kinthelt/be6502/kicad/be6502.pdf

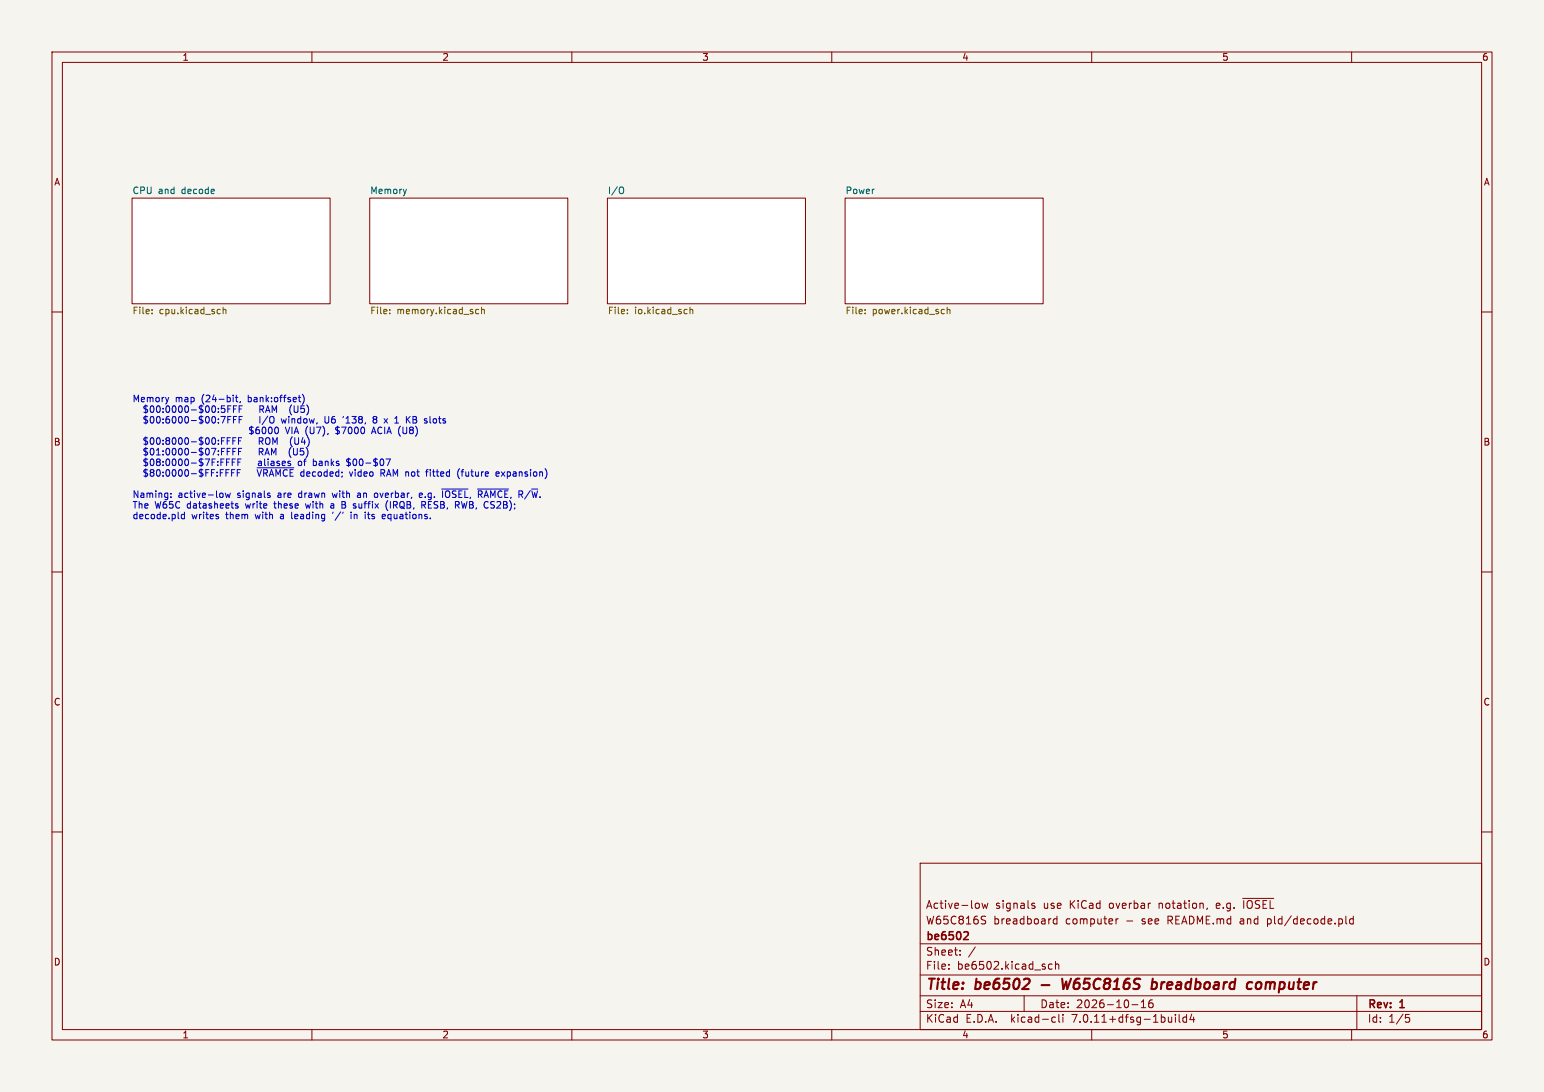
[picture p1: page 1]

CPU and decode File: cpu.kicad_sch

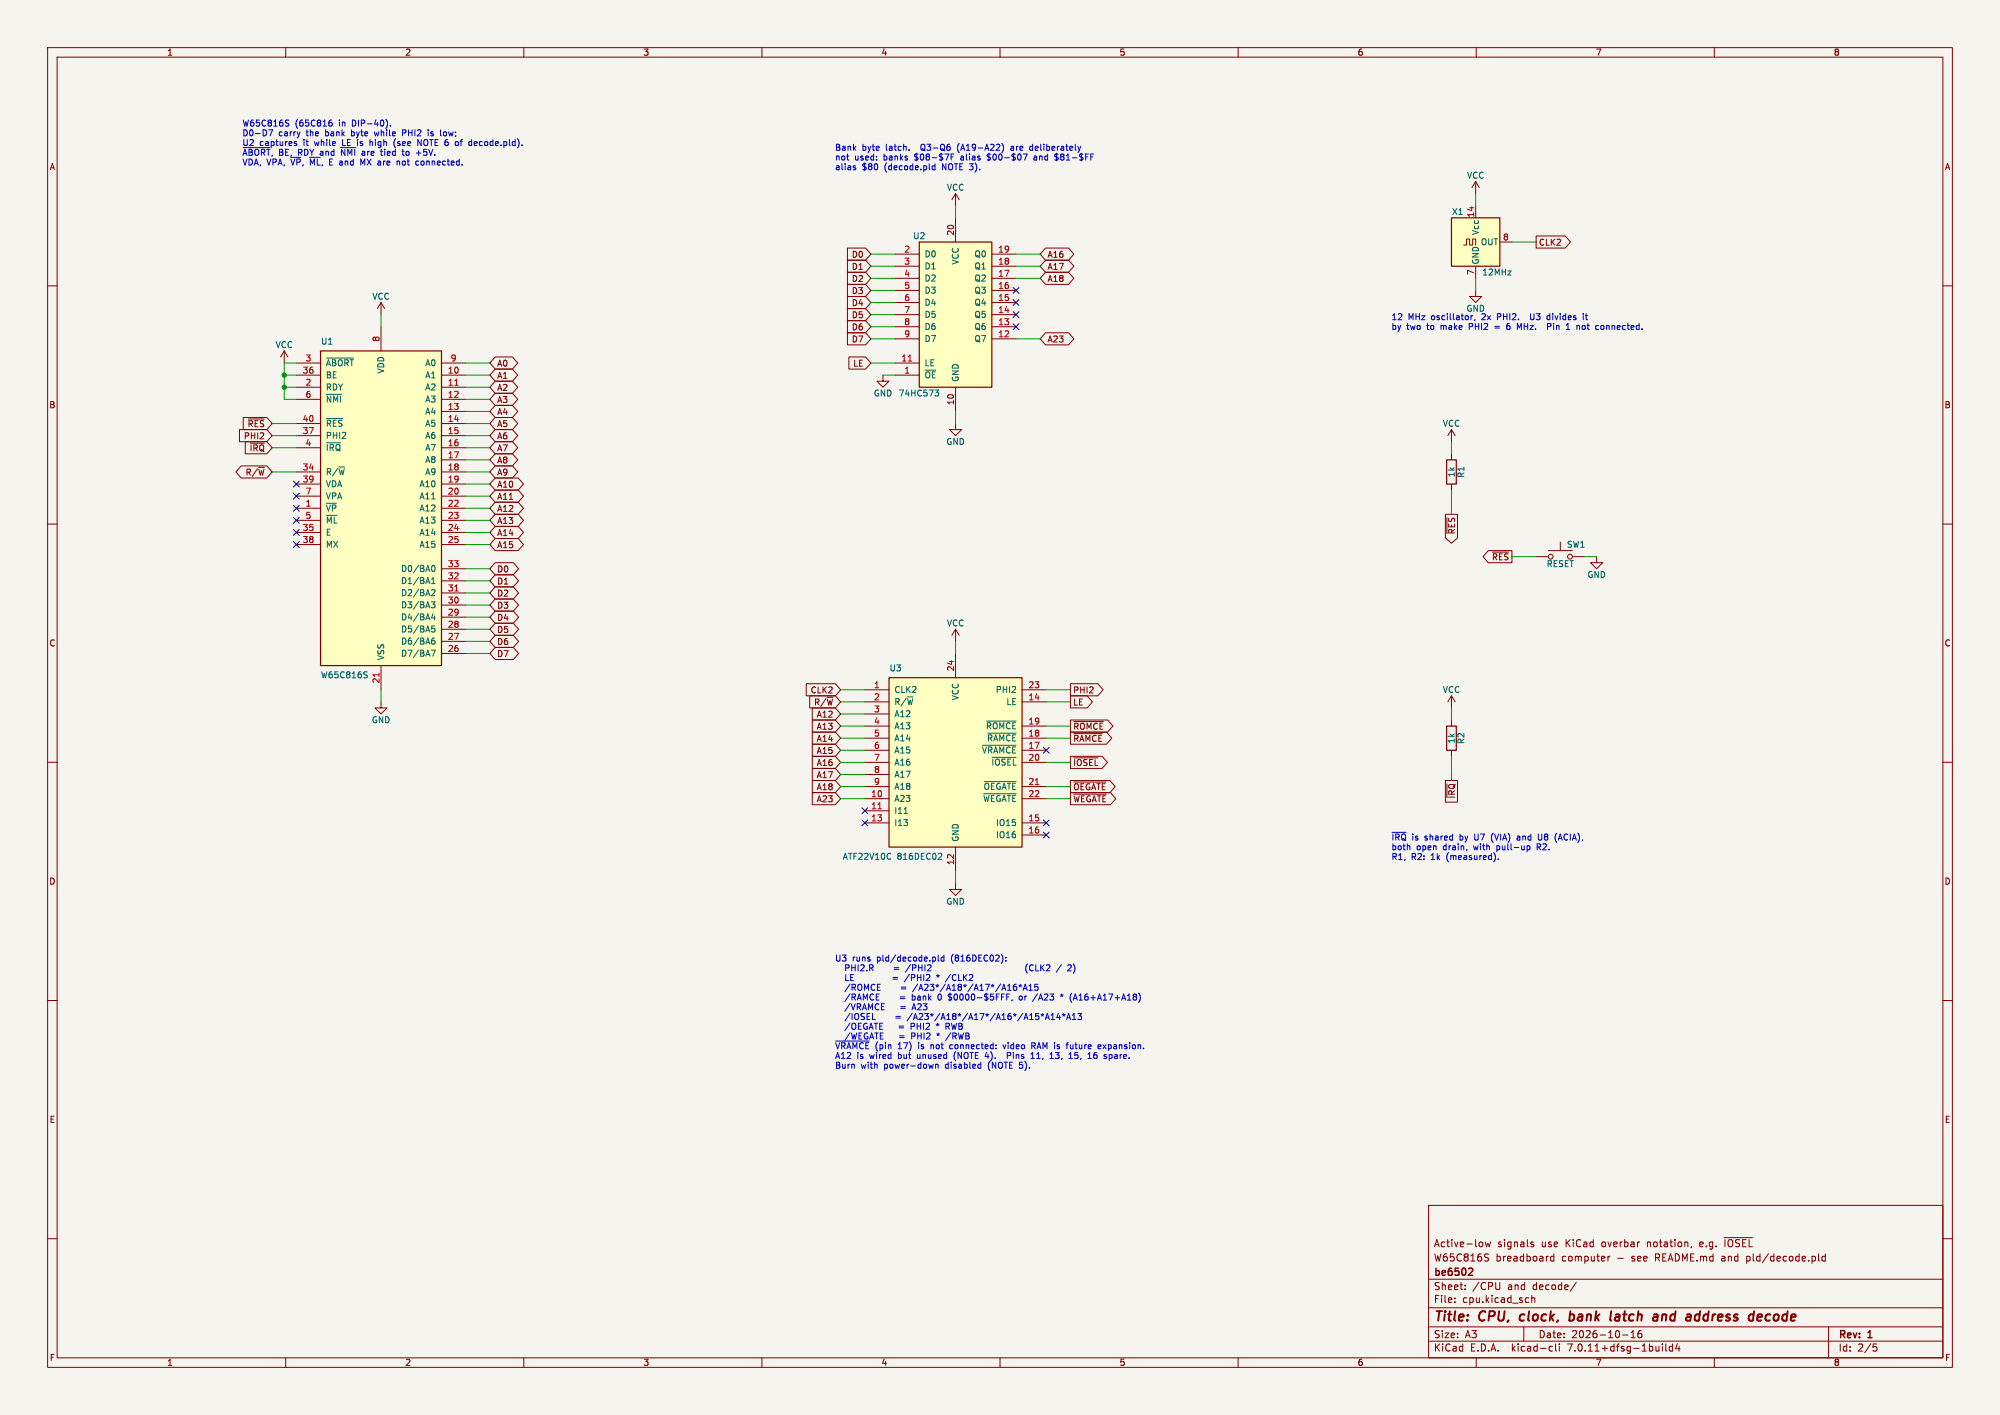
[picture p2: page 2]

~{ABORT},BE, RDY and ~{NMI}are tied to +5V. VDA, VPA, ~{VP},~{ML},E and MX are not connected.

Id: 2/5 Title: CPU, clock, bank latch and address decode

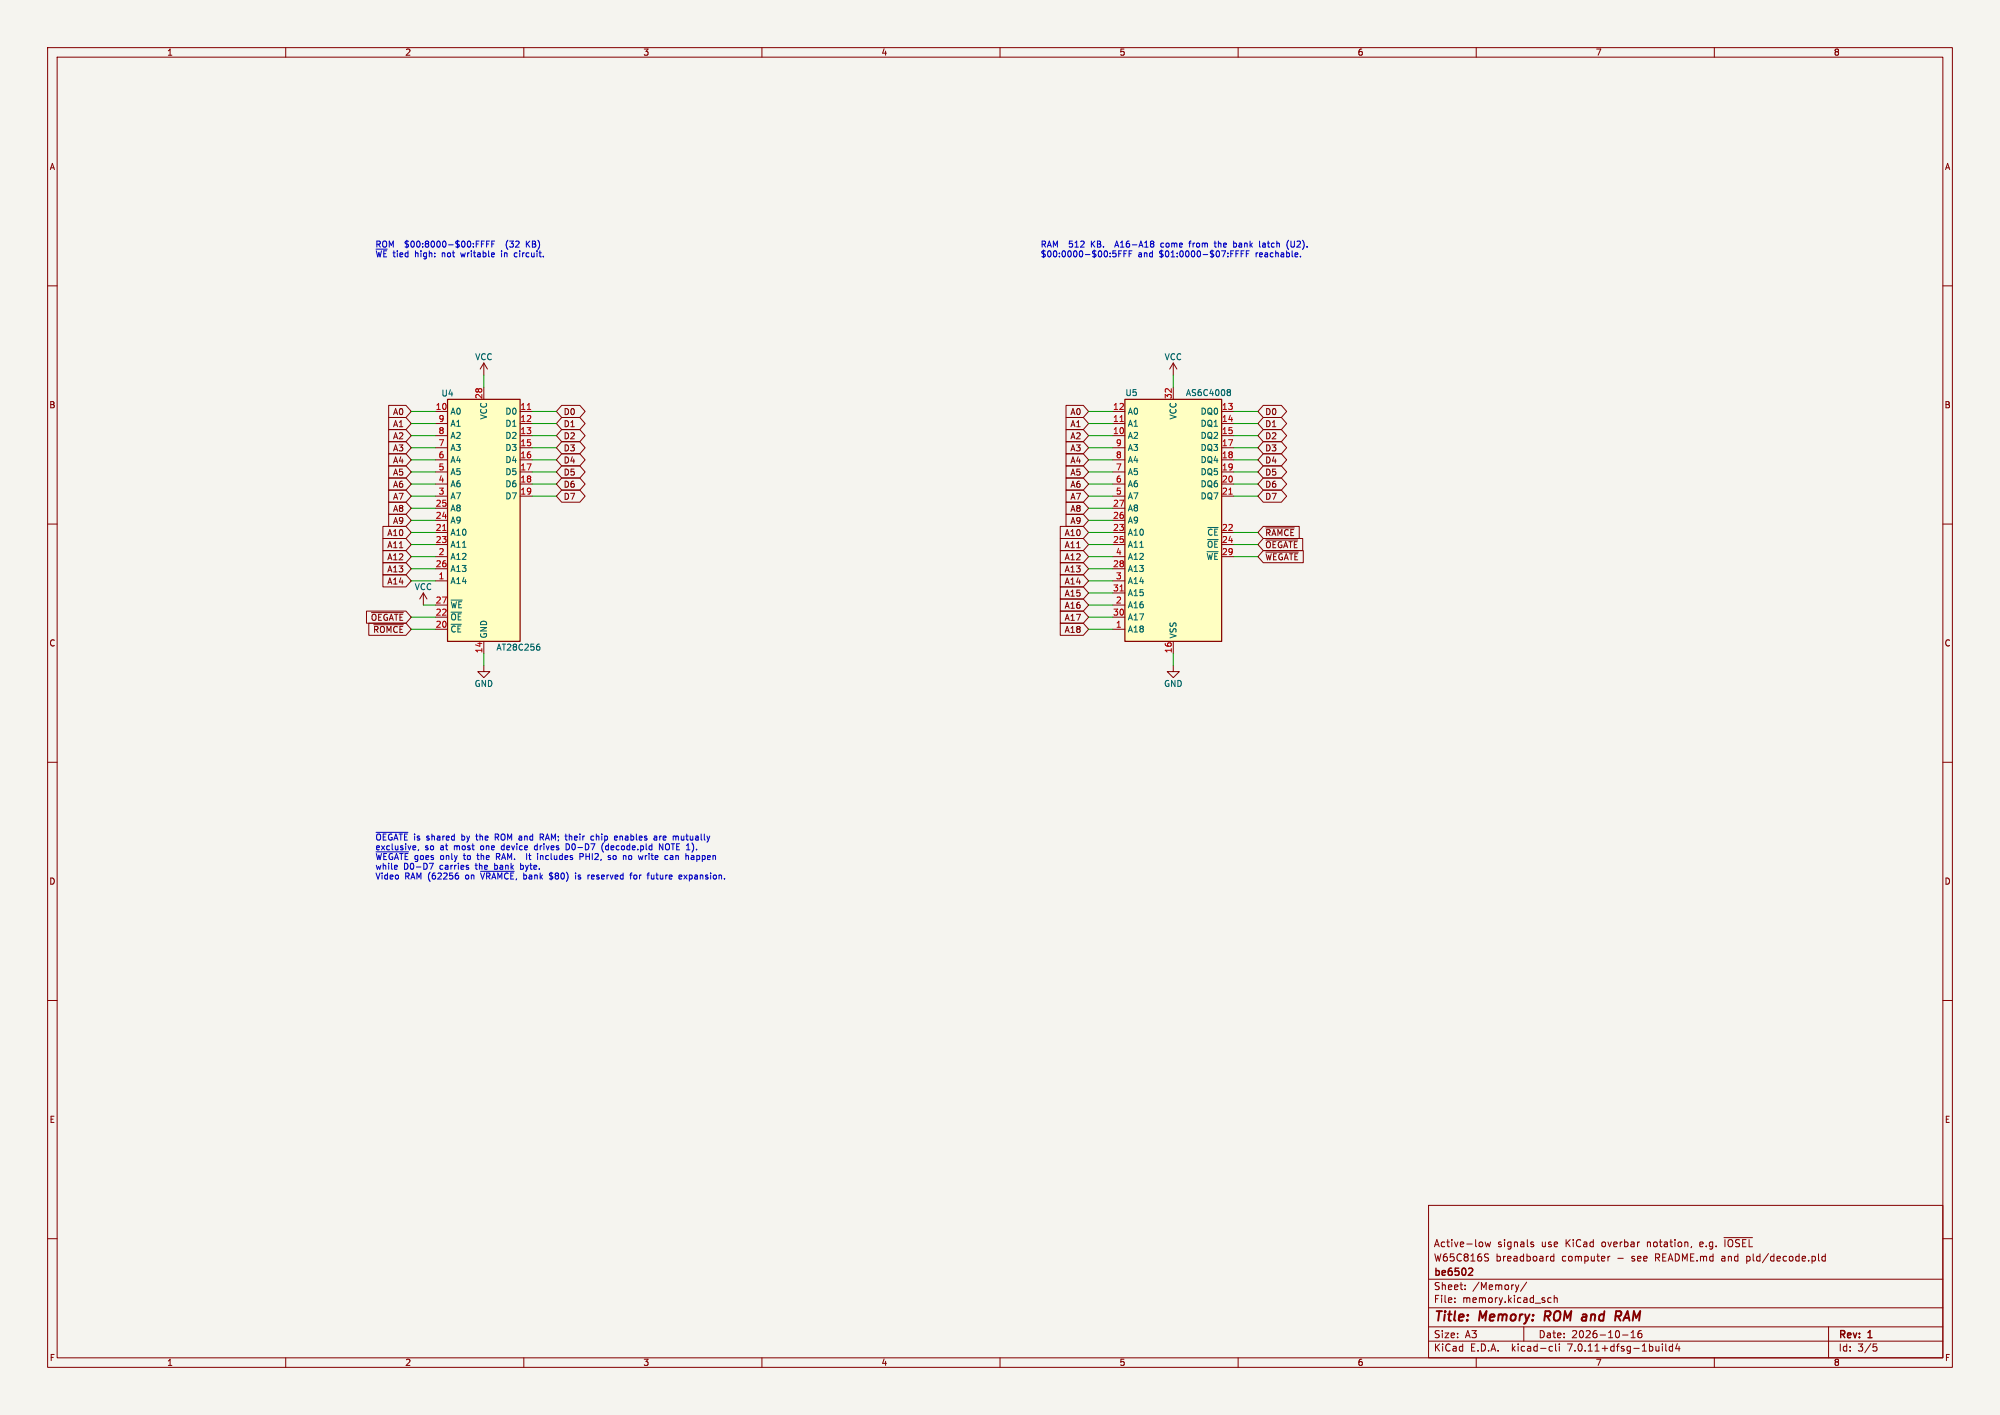
[picture p3: page 3]

Id: 3/5 Title: Memory: ROM and RAM

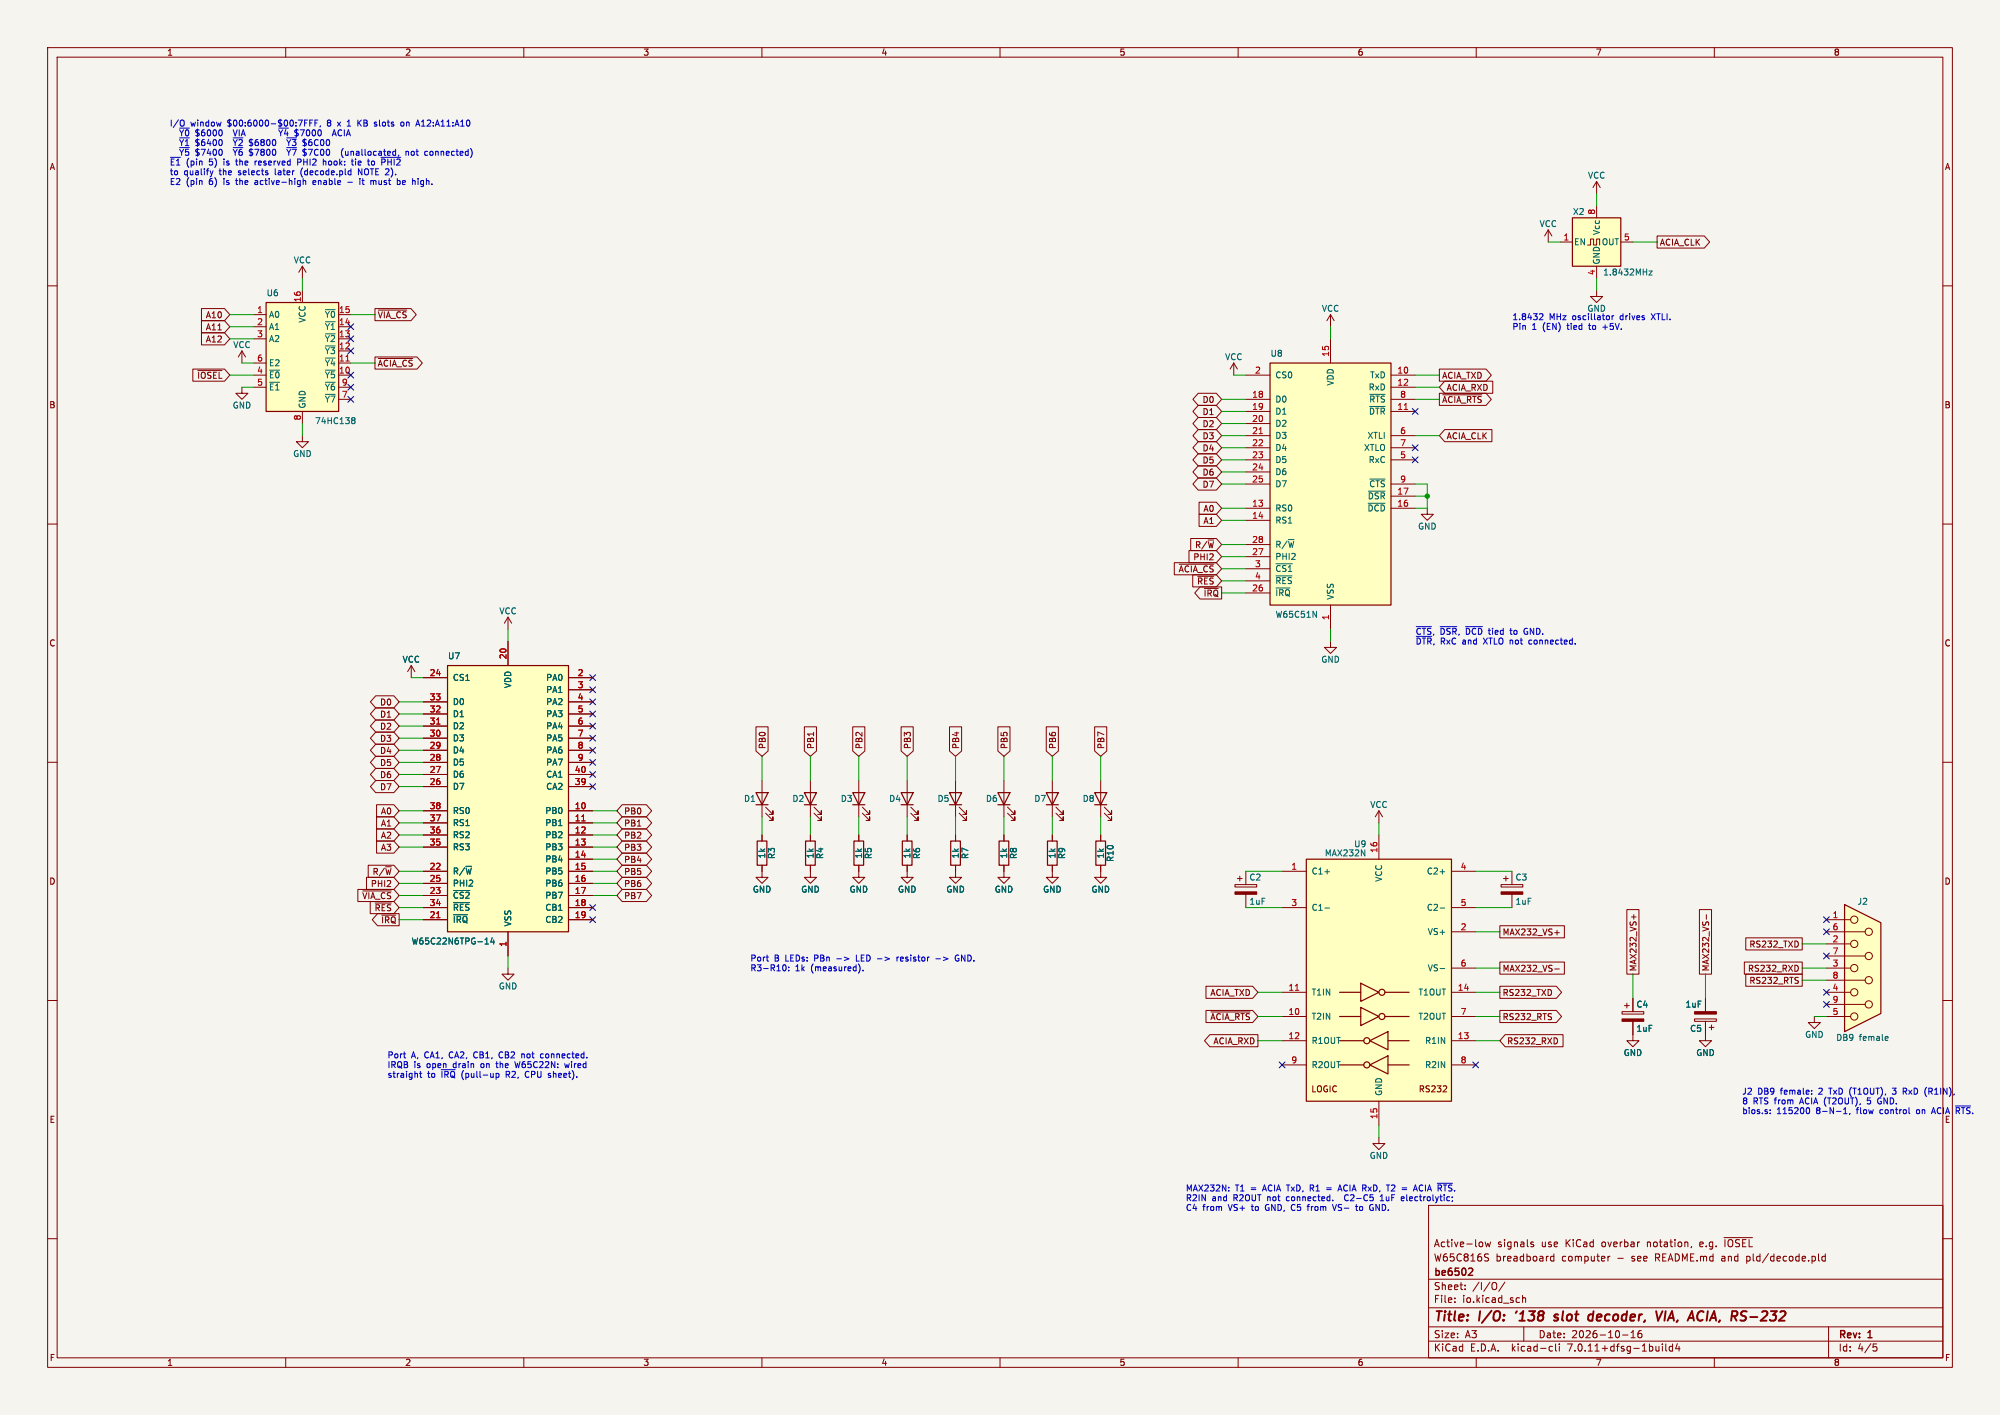
[picture p4: page 4]

~{E1}(pin 5) is the reserved PHI2 hook: tie to ~{PHI2}

1 TxD 10 ~{DTR}11 RxD 12 RS0 13 RS1 14 VDD 15

IRQB is open drain on the W65C22N: wired

Id: 4/5 Title: I/O: '138 slot decoder, VIA, ACIA, RS-232

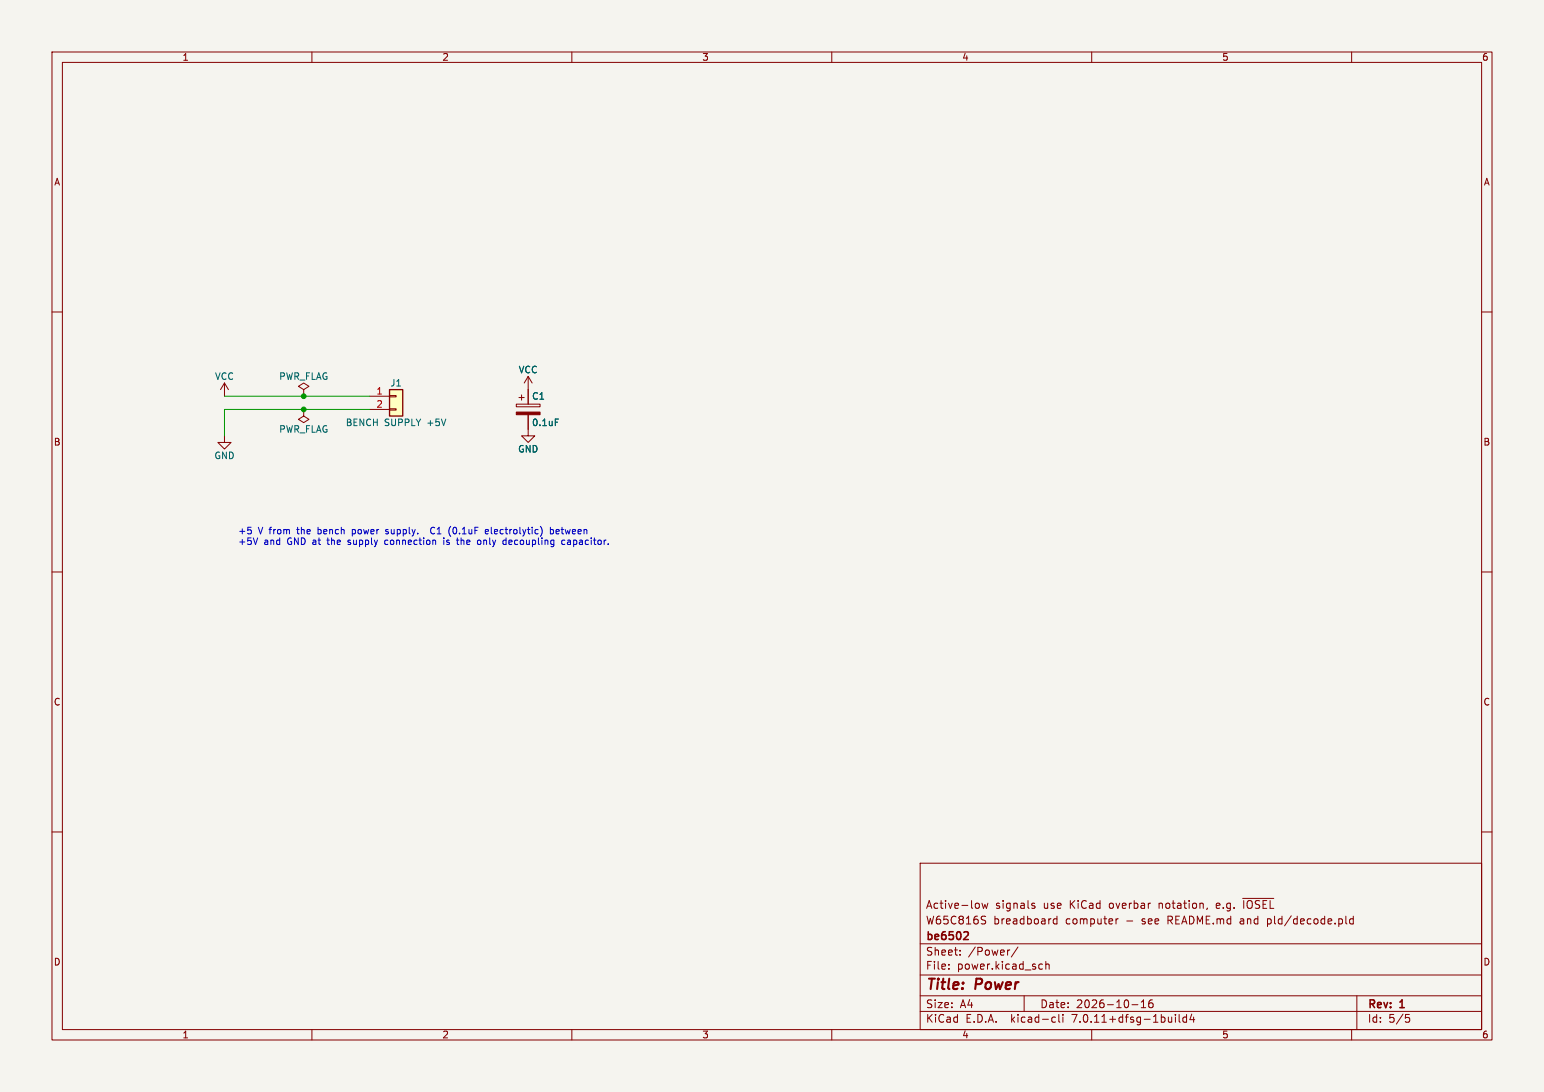
[picture p5: page 5]
