kinthelt/be6502/kicad/cpu.kicad_sch

## KiCad design kicad/cpu.kicad_sch (2026-10-16)

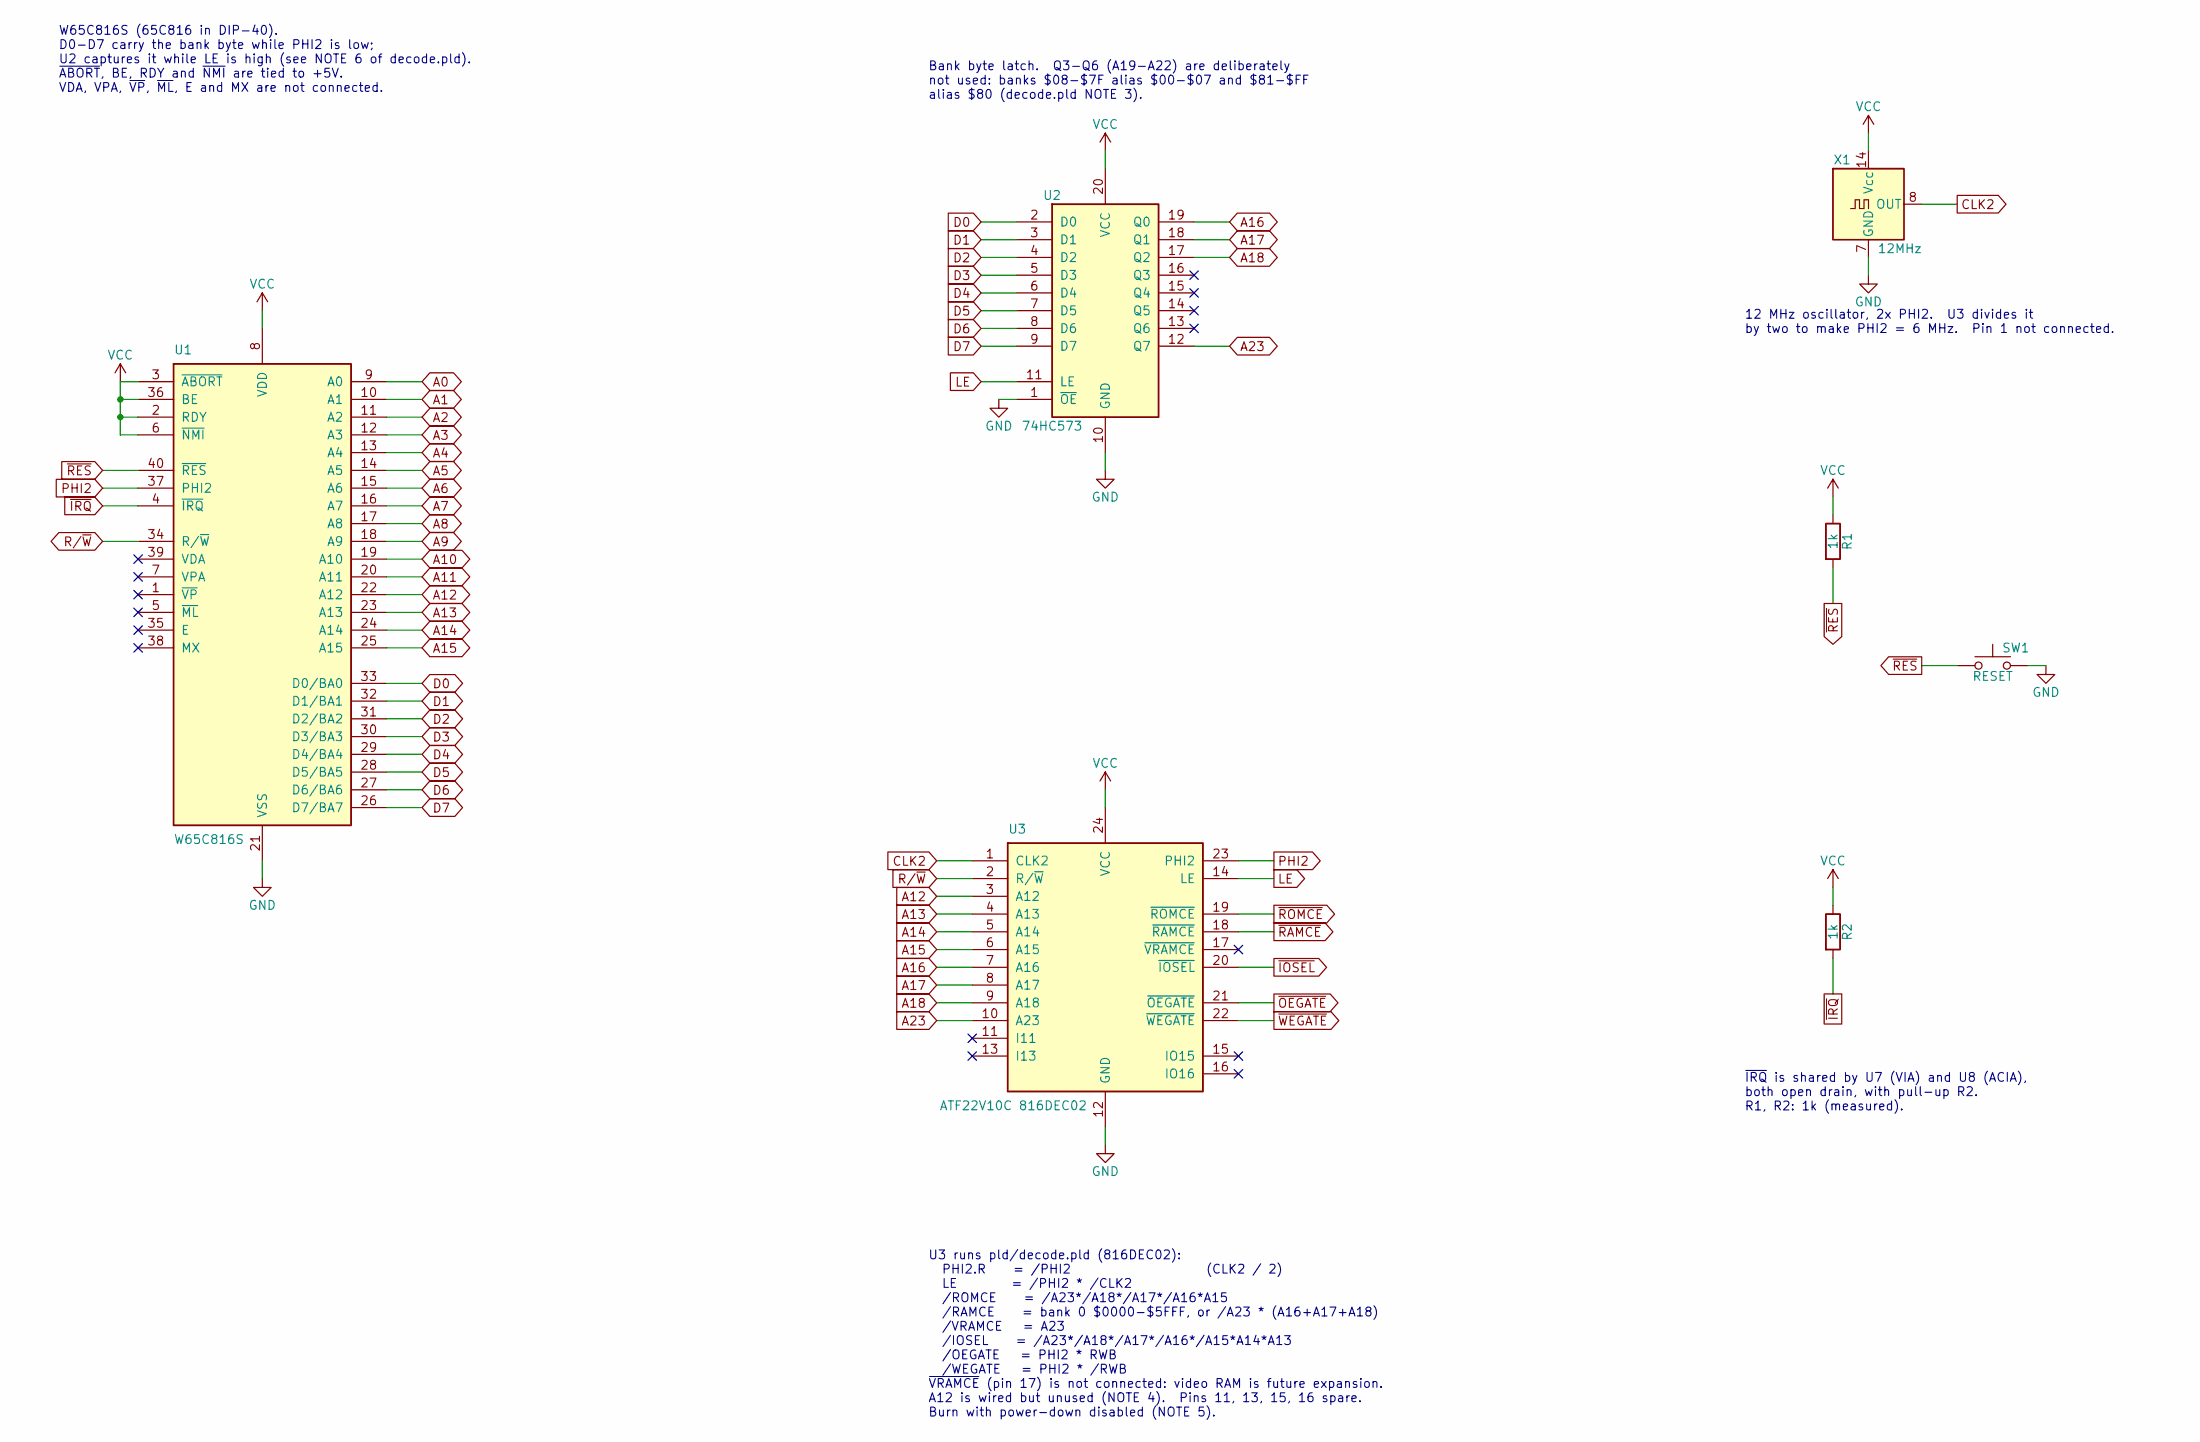
[picture p6: schematic cpu.kicad_sch]

Parts:
R1, R2: 1k
SW1: RESET
U1: W65C816S; DIP-40_W15.24mm
U2: 74HC573; DIP-20_W7.62mm
U3: ATF22V10C 816DEC02; DIP-24_W7.62mm
X1: 12MHz; Oscillator_DIP-14

Connections:
A0: U1.9 (A0)
A1: U1.10 (A1)
A2: U1.11 (A2)
A3: U1.12 (A3)
A4: U1.13 (A4)
A5: U1.14 (A5)
A6: U1.15 (A6)
A7: U1.16 (A7)
A8: U1.17 (A8)
A9: U1.18 (A9)
A10: U1.19 (A10)
A11: U1.20 (A11)
A12: U1.22 (A12), U3.3 (A12)
A13: U1.23 (A13), U3.4 (A13)
A14: U1.24 (A14), U3.5 (A14)
A15: U1.25 (A15), U3.6 (A15)
A16: U2.19 (Q0), U3.7 (A16)
A17: U2.18 (Q1), U3.8 (A17)
A18: U2.17 (Q2), U3.9 (A18)
A23: U2.12 (Q7), U3.10 (A23)
CLK2: U3.1 (CLK2), X1.8 (OUT)
D0: U1.33 (D0/BA0), U2.2 (D0)
D1: U1.32 (D1/BA1), U2.3 (D1)
D2: U1.31 (D2/BA2), U2.4 (D2)
D3: U1.30 (D3/BA3), U2.5 (D3)
D4: U1.29 (D4/BA4), U2.6 (D4)
D5: U1.28 (D5/BA5), U2.7 (D5)
D6: U1.27 (D6/BA6), U2.8 (D6)
D7: U1.26 (D7/BA7), U2.9 (D7)
GND: SW1.2, U1.21 (VSS), U2.1 (~OE), U2.10 (GND), U3.12 (GND), X1.7 (GND)
LE: U2.11 (LE), U3.14 (LE)
PHI2: U1.37 (PHI2), U3.23 (PHI2)
R/~W: U1.34 (R/~W), U3.2 (R/~W)
VCC: R1.1, R2.1, U1.2 (RDY), U1.3 (~ABORT), U1.6 (~NMI), U1.8 (VDD), U1.36 (BE), U2.20 (VCC), U3.24 (VCC), X1.14 (Vcc)
~IOSEL: U3.20 (~IOSEL)
~IRQ: R2.2, U1.4 (~IRQ)
~OEGATE: U3.21 (~OEGATE)
~RAMCE: U3.18 (~RAMCE)
~RES: R1.2, SW1.1, U1.40 (~RES)
~ROMCE: U3.19 (~ROMCE)
~WEGATE: U3.22 (~WEGATE)

Notes on the sheet:
W65C816S (65C816 in DIP-40). D0-D7 carry the bank byte while PHI2 is low; U2 captures it while LE is high (see NOTE 6 of decode.pld). ~{ABORT}, BE, RDY and ~{NMI} are tied to +5V. VDA, VPA, ~{VP}, ~{ML}, E and MX are not connected.
Bank byte latch. Q3-Q6 (A19-A22) are deliberately not used: banks $08-$7F alias $00-$07 and $81-$FF alias $80 (decode.pld NOTE 3).
U3 runs pld/decode.pld (816DEC02): PHI2.R = /PHI2 (CLK2 / 2) LE = /PHI2 * /CLK2 /ROMCE = /A23*/A18*/A17*/A16*A15 /RAMCE = bank 0 $0000-$5FFF, or /A23 * (A16+A17+A18) /VRAMCE = A23 /IOSEL = /A23*/A18*/A17*/A16*/A15*A14*A13 /OEGATE = PHI2 * RWB /WEGATE = PHI2 * /RWB ~{VRAMCE} (pin 17) is not connecte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
12 MHz oscillator, 2x PHI2. U3 divides it by two to make PHI2 = 6 MHz. Pin 1 not connected.
~{IRQ} is shared by U7 (VIA) and U8 (ACIA), both open drain, with pull-up R2. R1, R2: 1k (measured).
