kinthelt/be6502/kicad/memory.kicad_sch

## KiCad design kicad/memory.kicad_sch (2026-10-16)

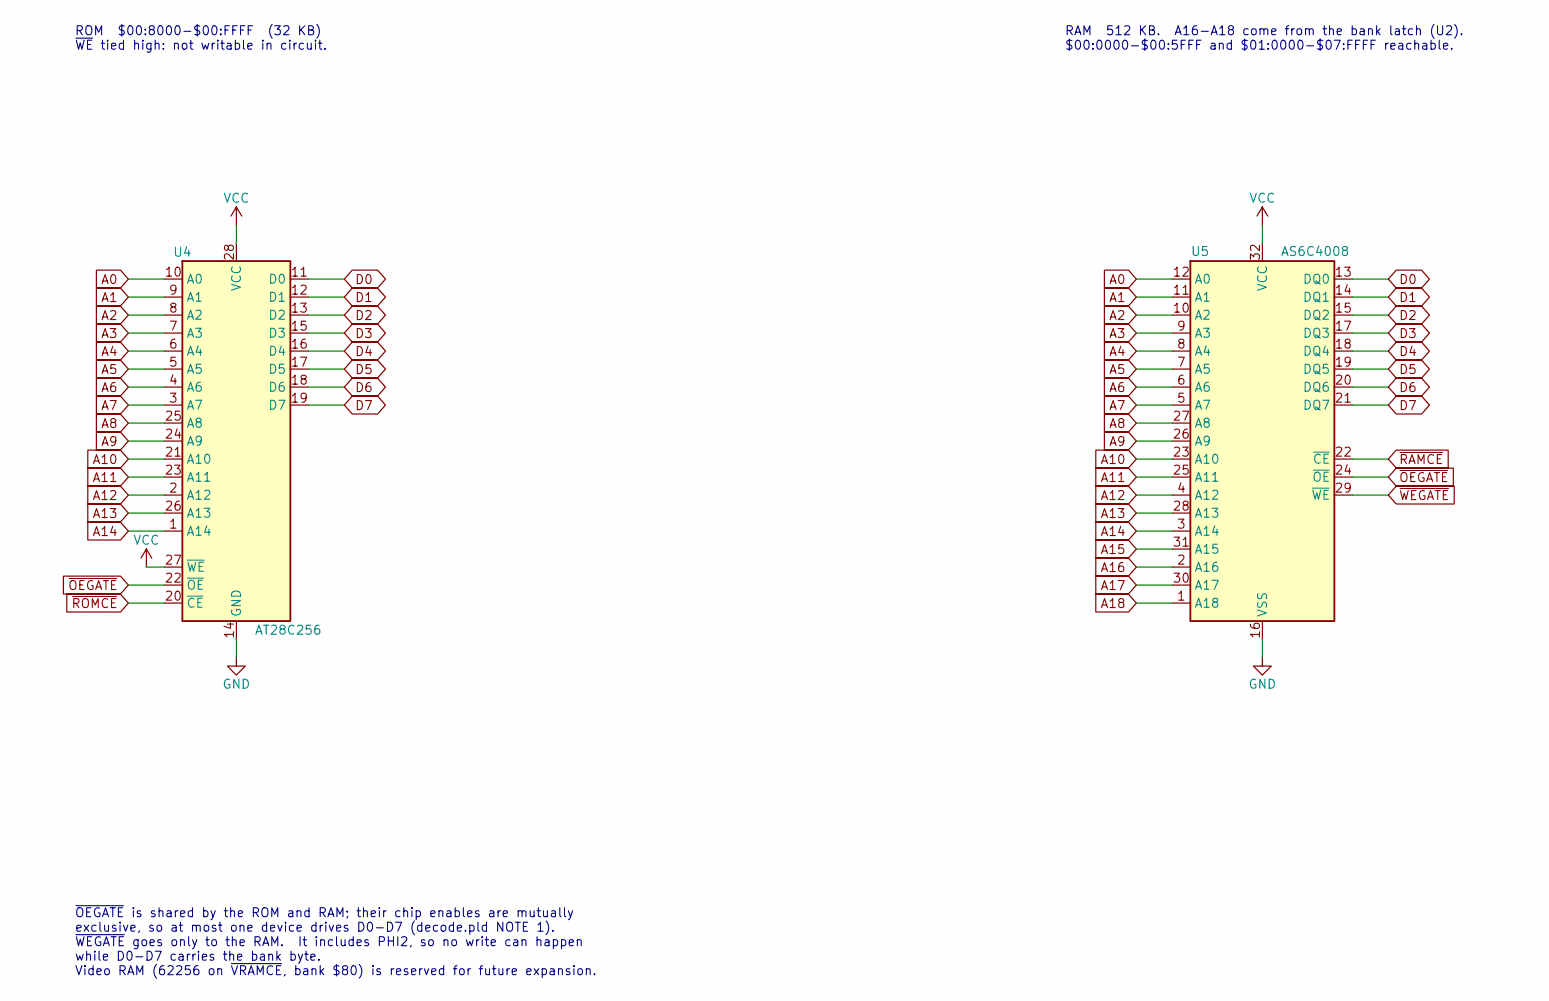
[picture p7: schematic memory.kicad_sch]

Parts:
U4: AT28C256; DIP-28_W15.24mm
U5: AS6C4008; DIP-32_W15.24mm

Connections:
A0: U4.10 (A0), U5.12 (A0)
A1: U4.9 (A1), U5.11 (A1)
A2: U4.8 (A2), U5.10 (A2)
A3: U4.7 (A3), U5.9 (A3)
A4: U4.6 (A4), U5.8 (A4)
A5: U4.5 (A5), U5.7 (A5)
A6: U4.4 (A6), U5.6 (A6)
A7: U4.3 (A7), U5.5 (A7)
A8: U4.25 (A8), U5.27 (A8)
A9: U4.24 (A9), U5.26 (A9)
A10: U4.21 (A10), U5.23 (A10)
A11: U4.23 (A11), U5.25 (A11)
A12: U4.2 (A12), U5.4 (A12)
A13: U4.26 (A13), U5.28 (A13)
A14: U4.1 (A14), U5.3 (A14)
A15: U5.31 (A15)
A16: U5.2 (A16)
A17: U5.30 (A17)
A18: U5.1 (A18)
D0: U4.11 (D0), U5.13 (DQ0)
D1: U4.12 (D1), U5.14 (DQ1)
D2: U4.13 (D2), U5.15 (DQ2)
D3: U4.15 (D3), U5.17 (DQ3)
D4: U4.16 (D4), U5.18 (DQ4)
D5: U4.17 (D5), U5.19 (DQ5)
D6: U4.18 (D6), U5.20 (DQ6)
D7: U4.19 (D7), U5.21 (DQ7)
GND: U4.14 (GND), U5.16 (VSS)
VCC: U4.27 (~WE), U4.28 (VCC), U5.32 (VCC)
~OEGATE: U4.22 (~OE), U5.24 (~OE)
~RAMCE: U5.22 (~CE)
~ROMCE: U4.20 (~CE)
~WEGATE: U5.29 (~WE)

Notes on the sheet:
ROM $00:8000-$00:FFFF (32 KB) ~{WE} tied high: not writable in circuit.
RAM 512 KB. A16-A18 come from the bank latch (U2). $00:0000-$00:5FFF and $01:0000-$07:FFFF reachable.
~{OEGATE} is shared by the ROM and RAM; their chip enables are mutually exclusive, so at most one device drives D0-D7 (decode.pld NOTE 1). ~{WEGATE} goes only to the RAM. It includes PHI2, so no write can happen while D0-D7 carries the bank byte. Video RAM (62256 on ~{VRAMCE}, bank $80) is reserved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
