kinthelt/be6502/kicad/power.kicad_sch

## KiCad design kicad/power.kicad_sch (2026-10-16)

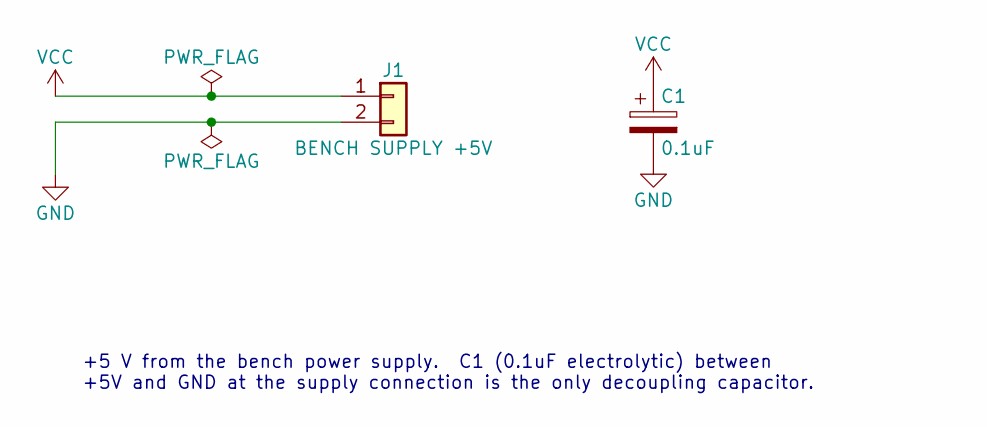
[picture p8: schematic power.kicad_sch]

Parts:
C1: 0.1uF
J1: BENCH SUPPLY +5V

Connections:
GND: C1.2, J1.2
VCC: C1.1, J1.1

Notes on the sheet:
+5 V from the bench power supply. C1 (0.1uF electrolytic) between +5V and GND at the supply connection is the only decoupling capacitor.
