kinthelt/be6502/(commit log)

2026-09-21 Add memtest.s: RAM bank memory test boot ROM
    Exercises banks $01-$07 by writing and reading back a pseudo-random
    byte at a pseudo-random offset in each bank, using 65C816 direct-page
    indirect-long addressing to reach full 24-bit addresses from
    emulation mode. A 16-bit Galois LFSR drives address/data generation
    and runs one full period ($FFFF tests) per bank. Writes $01 to the
    VIA on success, $02 on the first mismatch.
    Includes memtest.cfg, the ld65 linker script needed to build it into
    a 32KB ROM image at $8000-$FFFF.
    Claude-Session: https://claude.ai/code/session_01Du58MzmNhvs3GcMKZrKRZt
    [memtest.cfg]
2026-09-21 Port memtest.s from ca65 to vasm oldstyle syntax
    Rewrites the directives to target vasm6502_oldstyle -816 -Fbin -dotdir:
    - .p816/.a8/.i8 -> .as/.xs (8-bit accumulator/index, still emulation-mode)
    - = constants -> equ
    - .segment "CODE"/"VECTORS" + external ld65 script -> inline org $8000 /
    org $ffe4, since -Fbin needs no linker script
    - .addr -> dc.w
    - ca65's anonymous local label (:+) -> a named count_dec label, since
    oldstyle syntax has no equivalent
    Drops memtest.cfg, which was the ld65 script for the old .segment
    layout and no longer applies.
    The write/read/compare logic, LFSR, loop structure, and vector table
    are unchanged from the ca65 version. I was not able to install vasm
    in th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
    [memtest.cfg]
2026-09-21 Added Makefile to simplify creation of ROM binaries. Added count.s as a VIA test. memtest.s now assembles.
2026-09-22 Blank out all LEDs in memtest.s
    Added code to turn off all LEDs by writing 0 to VIA_ORB.
2026-09-22 Update status codes in memtest.s
    Display the bank on the LEDs as an update message.
    Success now lights up last LED.
    Failure lights up 2nd last LED.
2026-09-22 Revise W65C816S decode for clock and latch enable
    Updated the decode file for W65C816S with new clock divider and latch enable logic. Supersedes 816DEC01, with changes to pin assignments and functionality.
2026-09-28 RS-232 test program.
    All keystrokes are echoed back, and data is shown on the LEDs.
2026-09-29 Work in progress
    vasm is out. ca65 is in.
    Creating BIOS. Wozmon is the default interface.
    Wozmon modified to use BIOS subroutines (WIP).
    Added a count.s program to demo Wozmon program entry.
    [bios.cfg, mem.cfg]
2026-09-29 Updated connect script to 115200bps Copied memtest to programs directory BIOS now returns a line feed when it prints a carriage return
    [bios.cfg]
2026-09-29 Add 24-bit bank addressing and N (native mode) command to Wozmon
    Wozmon now parses up to six hex digits as bank:offset, so it can
    examine, block-examine and store in any bank. Four or fewer digits
    still mean bank $00. Examine and store carry across bank boundaries,
    and addresses print as six digits.
    R now jumps with JML so it can reach any bank. When the target is
    outside bank $00 it disables interrupts first, because emulation-mode
    interrupts return to bank $00. N switches to native mode and calls the
    program JSL-style. When the program returns with RTL, Wozmon goes back
    to emulation mode, resets the data bank, direct page and decimal flag,
    re-enables interrupts, and prompts again.
    The BI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
    [bios.cfg]
2026-09-29 Run prog/count.s in 65816 native mode
    The program switches itself to native mode, so it works with either
    N or R from Wozmon. The counter stays in 8-bit A, so each store writes
    only port B. The delay now uses one 16-bit DEY/BNE loop instead of the
    nested 8-bit loops, at about the same speed.
    Claude-Session: https://claude.ai/code/session_01K46snnMDZ6ScZCTAsJzHFw
2026-09-29 Fixed a few small issues
    [bios.cfg, mem.cfg]
2026-10-01 Assembly larson scanner
2026-10-01 Add LONG_CALL macro for native-mode BIOS calls
    Each 6502-style BIOS routine now has a long-call entry point built from
    one macro. A program calls it with JSL from emulation or native mode,
    any bank, any register sizes, data bank and direct page. The wrapper
    saves the caller's mode, register sizes, index registers, data bank
    and direct page, switches to native mode with 8-bit registers, direct
    page $0000, data bank $00 and binary arithmetic, calls the routine with
    JSR, copies its carry result into the caller's saved flags, restores
    everything and returns with RTL.
    LOAD_L, SAVE_L, CHRIN_L and CHROUT_L are rebuilt with the macro and
    moved to a new fixed ROM area at $FC00-$FCFF, since they no l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
    [bios.cfg]
2026-10-01 More BIOS work
    Increased BIOS_L segment size.
    Made CHRIN non-echo by default
    Added CHRIN_ECHO for compatibility with MSBasic
    [bios.cfg]
2026-10-01 Hardware flow control when reading from ACIA
2026-10-01 Stubs for load/save via xmodem
    [bios.cfg]
2026-10-01 Fix XSAVE/XLOAD and add Wozmon S and L commands
    XSAVE called the receive routine instead of the send routine, both
    routines restored A/X/Y in the wrong order and set up the pointers from
    A and A+1 instead of reading the caller's table, the XMODEM receive
    buffer at $0300 overlapped the serial input buffer, and the transfer
    code only handled 16-bit addresses and executed BRK on errors.
    - XLOAD/XSAVE take zero-page pointers to 3-byte (24-bit) tables, keep
    A, X and Y, and return carry set on success.
    - Files are raw memory images (no load-address header). Transfers run
    across bank boundaries.
    - The sender does a real EOT/ACK handshake and ignores stray characters
    while it waits for ACK/NA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
    [bios.cfg]
2026-10-01 Wozmon: don't dump memory on a line with an S command
    Before parsing a line, Wozmon looks for an "S" and, if it finds one,
    examines silently, so "start.end S" goes straight to the XMODEM
    transfer instead of printing the whole range first.
    Claude-Session: https://claude.ai/code/session_01L29VkDQGmL5DqvJpuXaACN
2026-10-16 Add KiCad schematic for the W65C816S build
    Hierarchical KiCad 7 project in kicad/ drawn from README.md and
    pld/decode.pld (816DEC02): CPU, bank latch, GAL decode and clock;
    ROM/RAM/VRAM; '138 I/O slot decoder, VIA and ACIA; power.
    Active-low signals use overbar names (~{IOSEL}, ~{RAMCE}, R/~{W}, ...)
    in both net labels and pin names. Project symbol library includes
    custom W65C816S, W65C22, W65C51N and programmed ATF22V10C symbols.
    Connectivity checked against the intended netlist via kicad-cli.
    Claude-Session: https://claude.ai/code/session_01GgTWzZQQJPzWrEMiSDZH6j
2026-10-16 Update KiCad schematic to match the build as wired
    - Remove video RAM (future expansion); GAL ~{VRAMCE} is NC and
    ~{WEGATE} goes only to the RAM
    - VIA is a W65C22N6TPG-14: IRQB wired directly to ~{IRQ} (no diode)
    - RDY and ~{NMI} tied directly to +5V; only reset and ~{IRQ} pull-ups
    - ACIA clocked by a 1.8432 MHz DIP-8 oscillator on XTLI (EN high)
    - Serial through a MAX232N to a female DB9 (pins 2, 3, 8, 5)
    - VIA Port B drives eight LEDs with series resistors; Port A, CA/CB NC
    - Drop per-chip decoupling; single 0.1uF electrolytic at the supply
    - Unknown resistor values shown as '?'
    - Update kicad/README.md and README.md accordingly
    Cl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
2026-10-16 Show resistors R1-R10 as 1k (estimated)
    The markings are unreadable; 1k is the builder's estimate and is noted
    as such on the sheets and in kicad/README.md. Also list the unconnected
    DB9 pins explicitly.
    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
